palexander23/ultrasound-radar-circuit-design/README.md

# Ultrasonic Radar Circuit Design 

This repository contains LTSpice simulation files and design documents for an Ultrasonic Radar system with a max range of 5 m and a resolution of 12.9 mm.
It is designed for use on a relatively low-power robot.
The output is an 8-bit digital signal meant to be read by a microcontroller.
This project involved designing a comprehensive specification for all subsystems, designing circuits to the component level, and verifying that those circuits meet the specification.
Further details can be found in the [Project Report](Report.pdf)

This project was submitted for the award of an MEng in Electronics with Computer Systems during my 3rd year at the University of Southampton. 
It was submitted for a module on Mixed-signal Circuit Design.
It was designed to provide experience in electronic systems specification and design.

**Disclaimer:** This project has been made public purely for the purposes of creating a portfolio. 
If you are currently a student and Southampton do not attempt to submit some or all of this project as your own work. 
It will be flagged as plagiarism and there will be serious consequences.
 
## Directory Structure

### BlockDiagram
Contains the source file and exported image for the system block diagram.

### Circuits 
Contains LTSpice simulation files and images of those circuits sorted by sub-system.

### Report
Contains the LaTeX source for the project report.
Images are referenced from the Circuits directory.
