palexander23/ultrasound-radar-circuit-design/Report/Report.tex

\documentclass[12pt]{article}
\usepackage[a4paper, left = 24mm, top = 24mm, bottom = 24mm, right = 24mm]{geometry}
\usepackage{amsfonts, amsmath, amssymb}
\usepackage{gensymb}
\usepackage{fancyhdr}
\usepackage{pdfpages}
\usepackage{listings}
\usepackage{color}
\usepackage{pdfpages}
\usepackage{hyperref}
\usepackage{verbatim}
\usepackage[utf8]{inputenc}
\usepackage{graphicx}
\usepackage{float}
\usepackage{longtable}
\usepackage{fontenc}
\usepackage[backend=biber, style=ieee]{biblatex}
\usepackage{fontenc}
\usepackage{times}
\usepackage[ddmmyyyy]{datetime}
\usepackage{pdfpages}
\usepackage{subcaption}

\setlength{\parindent}{0pt}
\setlength{\parskip}{1em}

\addbibresource{biblo.bib}

\pagestyle{empty}

\begin{document}

\title{ELEC3208 Design Exercise CW FM Radar}
\author{Peter Alexander - 29462878}

\maketitle

\newpage
\tableofcontents
\newpage

% Content 
\include{content/SystemBlockDiagram}%
\include{content/Specification}%
\include{content/Implementation}%
\include{content/CriticalAnalysis}%

\printbibliography

\end{document}
