palexander23/ultrasound-radar-circuit-design/Circuits/Images/DifferentialAmp/Schematic.png

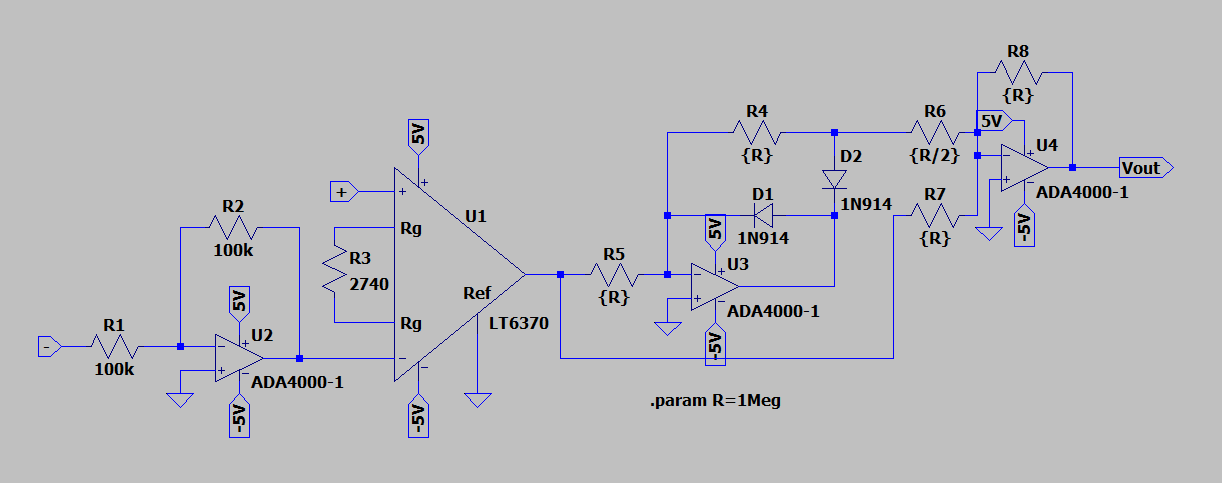
Circuits/Images/DifferentialAmp/Schematic.png
