palexander23/ultrasound-radar-circuit-design/Circuits/Images/DifferentialAmp/TestBench.png

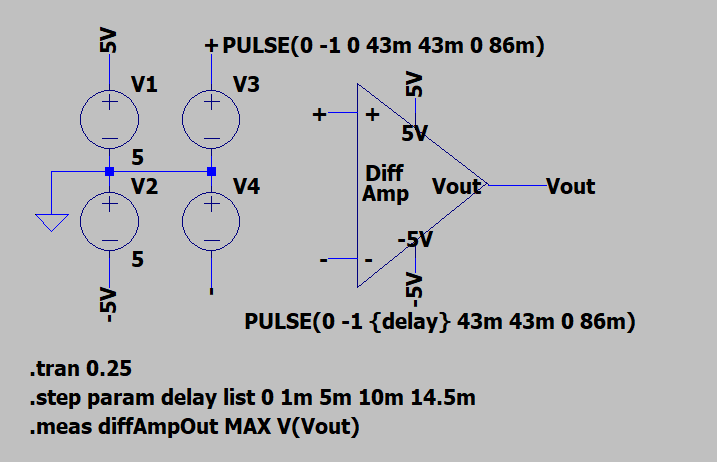
Circuits/Images/DifferentialAmp/TestBench.png
