palexander23/ultrasound-radar-circuit-design/Circuits/Images/Pre-Amp/TestBenchScreencap.png

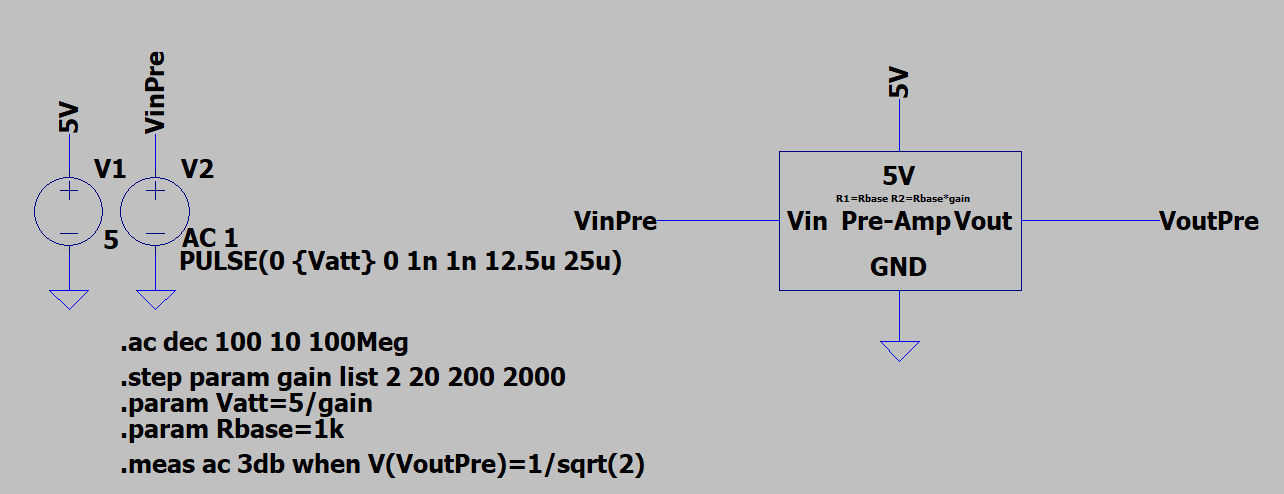
Circuits/Images/Pre-Amp/TestBenchScreencap.png
