palexander23/ultrasound-radar-circuit-design/Circuits/Images/TransmissionAmp/TestBenchScreencap.png

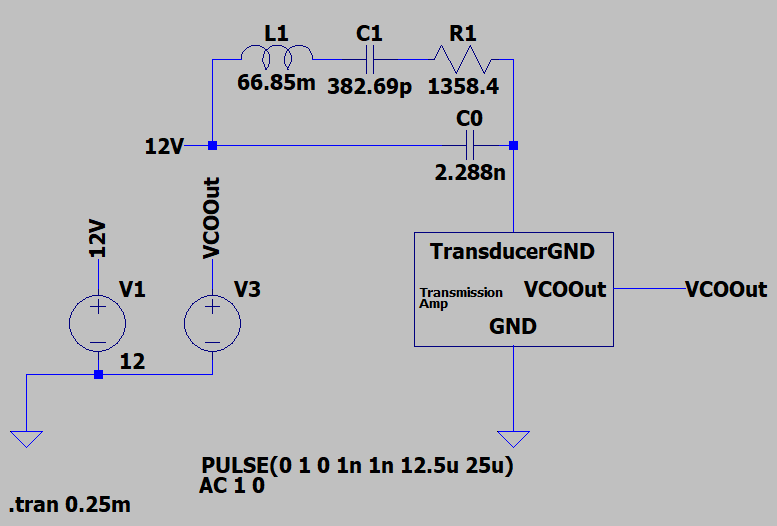
Circuits/Images/TransmissionAmp/TestBenchScreencap.png
