palexander23/ultrasound-radar-circuit-design/Circuits/SimulationFiles/AtoDConversion/TestBench.asc

V1: voltage; 5
V2: voltage; 5
V3: voltage; PULSE(0 -1 0 43m 43m 0 86m)
V4: voltage; PULSE(0 -1 {delay} 43m 43m 0 86m)
X1: DifferentialAmp
Named nets: 0, 5V, -5V, +, -, Vout
.tran 0.25
.step param delay list 0 1m 5m 10m 14.5m
.meas diffAmpOut MAX V(Vout)
