palexander23/ultrasound-radar-circuit-design/Circuits/SimulationFiles/Differentiator/TriangleWaveTestBench.asc

R1: res; 1Meg
V1: voltage; 5
V2: voltage; 5
X1: Differentiator
X2: TriangleWaveGenerator
Named nets: 0, 5V, -5V, Vin, Vout
.tran 0 1.3 0.5
