palexander23/ultrasound-radar-circuit-design/Circuits/SimulationFiles/PreAmp/TestBench.asc

V1: voltage; 5
V2: voltage; SINE(0 {Vatt} 0 1n 1n 12.5u 25u); AC 1
X2: preamp; R1=Rbase R2=Rbase*gain
Named nets: 0, 5V, VinPre, VoutPre
.step param gain list 2 20 200 2000
.param Vatt=5/gain
.ac dec 100 10 100Meg
.param Rbase=1k
.meas ac 3db when V(VoutPre)=1/sqrt(2)
