palexander23/ultrasound-radar-circuit-design/Circuits/SimulationFiles/TransmissionAmp/Testbench.asc

C0: cap; 2.288n
C1: cap; 382.69p
L1: ind; 66.85m
R1: res; 1358.4
V1: voltage; 12
V3: voltage; PULSE(0 5 0 1n 1n 12.5u 25u); AC 1 0
X2: TransmissionAmp
Named nets: 0, 12V, VCOOut
.tran 0.25m
