palexander23/ultrasound-radar-circuit-design/Circuits/SimulationFiles/VCO/Testbench.asc

V1: voltage; 5
V2: voltage; PWL(0m 0 4m 0 4.1m 1 4.5m 1 4.6m -1 5m -1 5.1m 0)
X1: VCO
Named nets: 0, 5V, VC, Vout
.tran 0 5.4m 3.9m
.meas t1centre find time when V(Vout)=2.5 cross=1 td=0.05m
.meas t2centre find time when V(Vout)=2.5 cross=3 td=0.05m
.meas fcentre PARAM 1/(t2centre-t1centre)
.meas t1low find time when V(Vout)=2.5 cross=1 td=0.3m
.meas t2low find time when V(Vout)=2.5 cross=3 td=0.3m
.meas fLow PARAM 1/(t2low-t1low)
.meas t1high find time when V(Vout)=2.5 cross=1 td=0.9m
.meas t2high find time when V(Vout)=2.5 cross=3 td=0.9m
.meas fHigh PARAM 1/(t2high-t1high)
.meas Bandwidth PARAM fHigh-fLow
