palexander23/ultrasound-radar-circuit-design/Circuits/SimulationFiles/TriangleWaveGenerator/TestBench.asc

V1: voltage; 5
V2: voltage; 5
X1: TriangleWaveGenerator
Named nets: 0, VCC, VDD, Vout
.tran 0 10 1
.meas TRAN Offset AVG V(Vout) TRIG V(Vout)=0 TD=1
.meas TRAN PeakToPeak PP V(Vout)
.meas t1 find time when V(vout)=0 cross=1 td=5s
.meas t2 find time when V(vout)=0 cross=3 td=5s
.meas F PARAM 1/(t2-t1)
