palexander23/ultrasound-radar-circuit-design/Circuits/SimulationFiles/AtoDConversion/DifferentialAmp.asc

D1: diode; 1N914
D2: diode; 1N914
R1: res; 100k
R2: res; 100k
R3: res; 2740
R4: res; {R}
R5: res; {R}
R6: res; {R/2}
R7: res; {R}
R8: res; {R}
U1: LT6370
U2: AD711
U3: AD711
U4: AD711
Named nets: 5V, -5V, 0, -, +, Vout, InvOut
.param R=1Meg
