palexander23/ultrasound-radar-circuit-design/Circuits/SimulationFiles/AtoDConversion/Differentiator.asc

C1: cap; 1000n
C2: cap; 50p
D1: diode; 1N914
R1: res; 1k
R2: res; 100k
U1: AD822
Named nets: 0, -5V, 5V, Vin, Vout, GND
