palexander23/ultrasound-radar-circuit-design/Circuits/SimulationFiles/Differentiator/ACTestbench.asc

V1: voltage; 5
V2: voltage; 5
V3: voltage; 5; AC 1
X1: Differentiator
Named nets: 0, 5V, -5V, Vin, Vout
.ac dec 100 1 100k
