palexander23/ultrasound-radar-circuit-design/Circuits/SimulationFiles/AnalogInverter/AnalogInverter.asc

R1: res; 1k
R2: res; 1k
U1: OP491
V1: voltage; 5
V2: voltage; 5
V3: voltage; PULSE(-1 1 0 50m 50m 0 100m)
Named nets: 0, Vout, Vin
.tran 1
