palexander23/ultrasound-radar-circuit-design/Circuits/SimulationFiles/PreAmp/preamp.asc

R1: res; {R1}
R2: res; {R2}
U1: AD8066
Named nets: 0, Vin, Vout, 5V, GND
.param R1=10k
.param R2=100k
Default Values
