palexander23/ultrasound-radar-circuit-design/Circuits/SimulationFiles/TransmissionAmp/TransmissionAmp.asc

M1: nmos; IRLML6344
R1: res; 200
Named nets: 0, GND, TransducerGND, VCOOut
