palexander23/ultrasound-radar-circuit-design/Circuits/SimulationFiles/Differentiator/TriangleWaveGenerator.asc

C1: cap; 1µ
R1: res; 110k
R2: res; 20k
R3: res; 100k
U1: AD8662
U2: AD8662
Named nets: VCC, 0, VDD, TriangleOut, 5V, -5V, GND
