palexander23/ultrasound-radar-circuit-design/Circuits/SimulationFiles/VCO/VCO.asc

R1: res; 976k
R2: res; 182k
RSET: res; 348k
RVCO: res; 3.16Meg
U1: LTC6990
Named nets: 0, VOUT, 5V, VC, GND
