palexander23/ultrasound-radar-circuit-design/Circuits/SimulationFiles/DemoCircuits/TrianleWaveGenerator.asc

C1: cap; 0.1µ
R1: res; 536k
R2: res; 2000
R3: res; 5000
U1: LT1013
U2: LT1013
V1: voltage; 5
V2: voltage; 5
Named nets: VCC, 0, VDD
.tran 0 10 1
