palexander23/ultrasound-radar-circuit-design/Circuits/SimulationFiles/DemoCircuits/AstableMultivibrator.asc

C1: cap; 0.01µ
C2: cap; 0.01µ
R1: res; 100k
R2: res; 1.8k
U1: NE555
V1: voltage; 5
Named nets: 0, VCC, Vout
.tran 0.25m
