palexander23/ultrasound-radar-circuit-design/(commit log)

2020-05-11 Initial commit, folders for LaTex report, circuit sims, and block diagram created with appropriate gitignores, initialised with README
2020-05-12 Add Simulation files and images gitignore, add 555 Astable Multivibrator demo circuit
2020-05-12 Add corections to ADC circuitry and placed boxes around subsections of the system
2020-05-15 Set project to run on +- 5V supply rather than just + 5V
2020-05-15 Add spec-meeting demo circuit of the VCO
2020-05-17 Add completed Modulation implementatation and circuits for preamp
2020-05-18 Add Differentiator implementation and good good circuits for the differential amplifier
